MateuszPtasz/trex-facade-weather-station/docs/gallery.md

# Prototype gallery

**English | [Polski](gallery_PL.md)**

This page documents the current working T-REX Facade Weather Station prototype.
Only public-safe photographs and screenshots are included: no saved Wi-Fi
credentials, private SSID or local network address is visible.

## RainPoint enclosure and power module

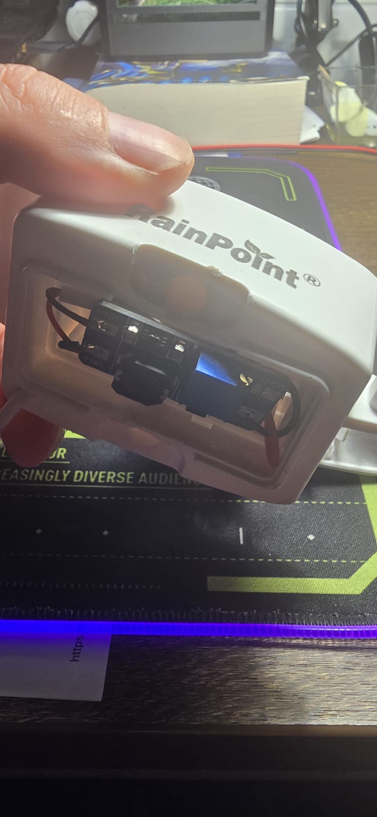
[picture p1: images/station-enclosure-power-module.jpeg]
RainPoint enclosure and stable 5 V module


The prototype reuses the RainPoint enclosure. An MT-series module provides a
stable 5 V supply inside the housing.

## Internal assembly

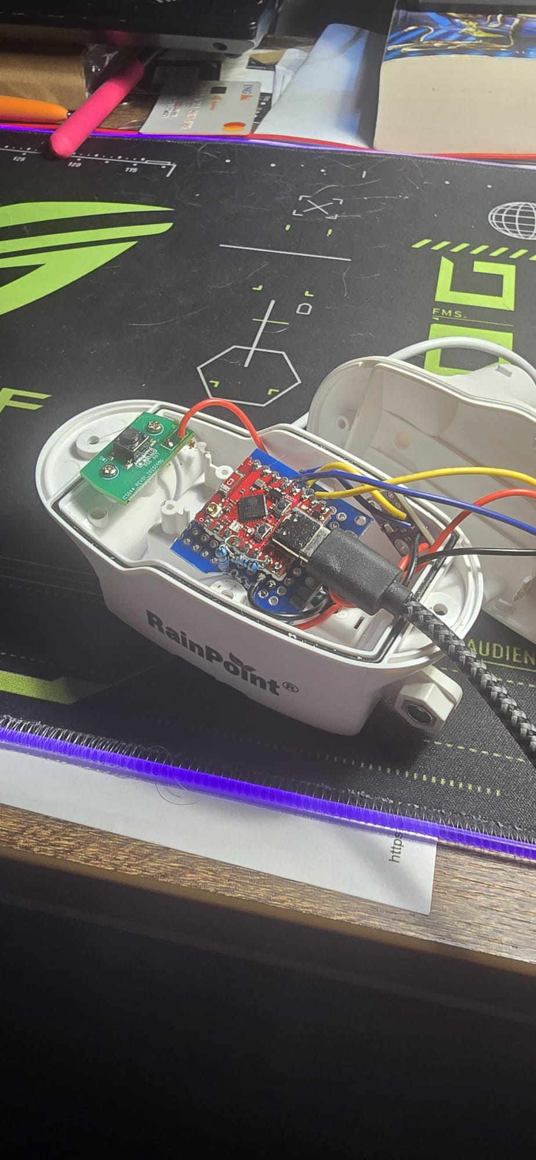
[picture p2: images/station-internal-esp32-c3-bme.jpeg]
ESP32-C3 Mini and BME sensor


ESP32-C3 Mini controller and BME temperature, humidity and pressure sensor
mounted in the prototype enclosure.

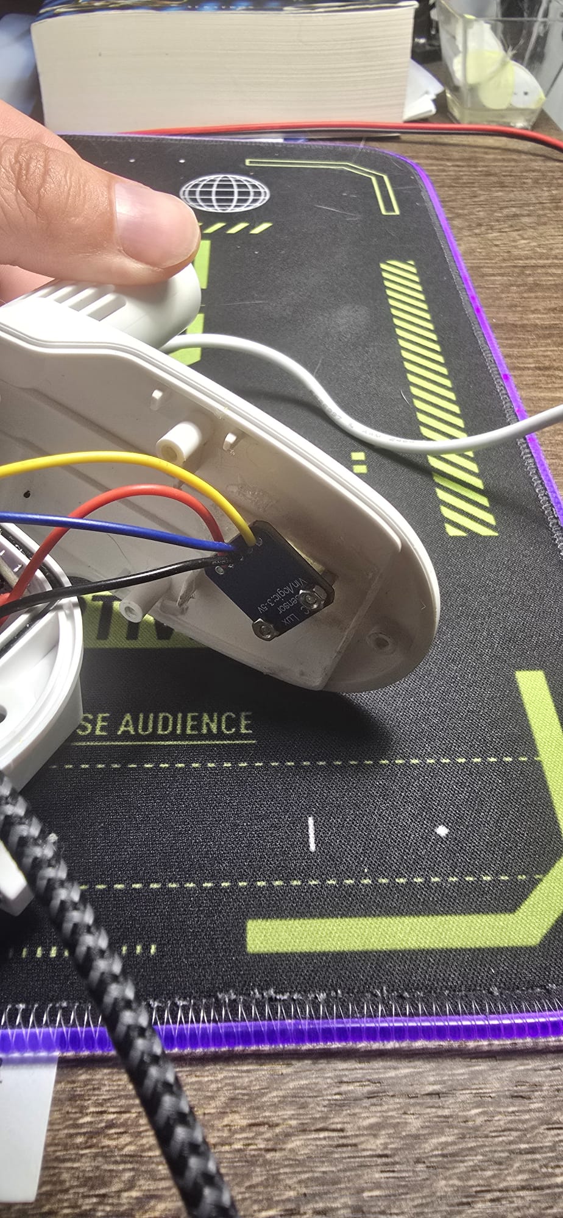
[picture p3: images/station-light-sensor.jpeg]
Ambient-light sensor


Dedicated ambient-light sensor prepared for the facade station.

## Web interface

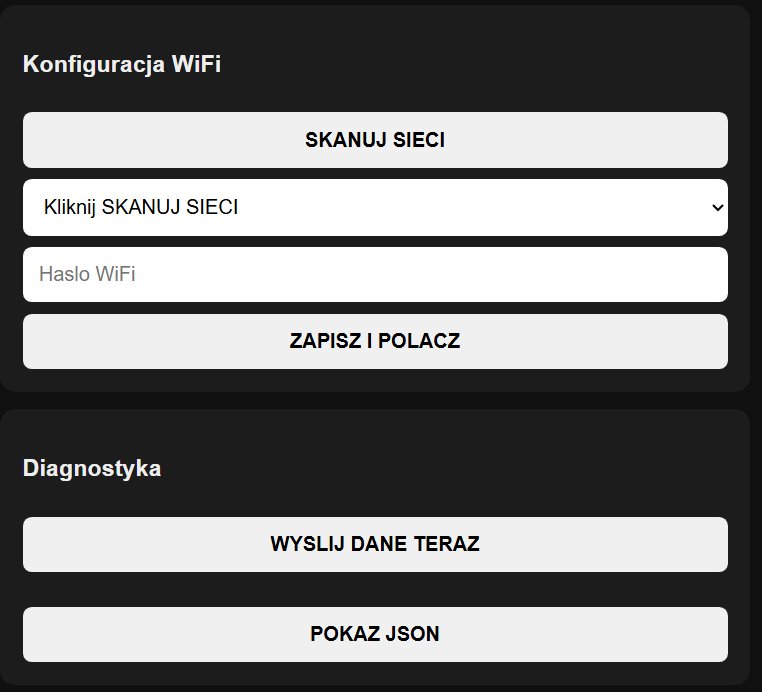
[picture p4: images/web-config.png]
Wi-Fi configuration page


The local web panel provides Wi-Fi setup and basic diagnostics. The screenshot
shows an empty configuration form only; it does not disclose a saved network or
password.

## Notes

These photographs show the current prototype rather than a production PCB or
final mechanical design. Component placement may change between builds. The
reproducible parts are the electrical wiring, firmware behavior and RainPoint
dry-contact logic documented elsewhere in this repository.
