MateuszPtasz/trex-facade-weather-station/(commit log)

2026-09-12 Link Polish wiring documentation
2026-09-12 Add Polish wiring documentation
2026-09-12 Document RainPoint enclosure integration
2026-09-12 Add wiring diagram and RainPoint enclosure notes
2026-09-13 Add prototype gallery documentation
